gastonvallasciani/4to20mA-Transmitter/README.md

# 4to20mA-Transmitter
4to20mA Transmitter, I2C and UART Bridges, Hardware Reset
