gastonvallasciani/4to20mA-Transmitter/Pinout.png

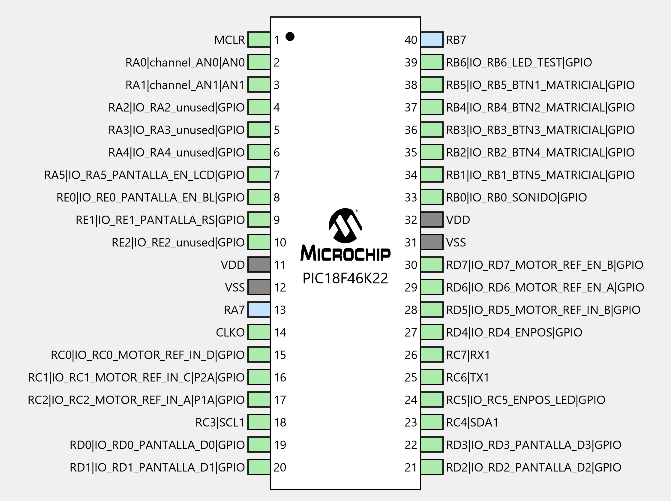
Pinout.png
