gastonvallasciani/4to20mA-Transmitter/(list of files, cad)

Other CAD files:
4to20mA-Transmitter.X/dist/default/production/Brainiac.production.obj
