gastonvallasciani/4to20mA-Transmitter/4to20mA-Transmitter.X/epwm3.h

/**
  ECCP3 Generated Driver File

  @Company
    Microchip Technology Inc.

  @File Name
    eccp3.c

  @Summary
    This is the generated driver implementation file for the ECCP3 driver using MPLAB(c) Code Configurator

  @Description
    This source file provides APIs for ECCP3.
    Generation Information :
        Product Revision  :  MPLAB(c) Code Configurator - 4.15
        Device            :  PIC18F46K22
        Driver Version    :  2.00
    The generated drivers are tested against the following:
        Compiler          :  XC8 1.35
        MPLAB             :  MPLAB X 3.40
*/

/*
    (c) 2016 Microchip Technology Inc. and its subsidiaries. You may use this
    software and any derivatives exclusively with Microchip products.

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
    IN NO EVENT WILL MICROCHIP BE LIABLE FOR ANY INDIRECT, SPECIAL, PUNITIVE,
    INCIDENTAL OR CONSEQUENTIAL LOSS, DAMAGE, COST OR EXPENSE OF ANY KIND
    WHATSOEVER RELATED TO THE SOFTWARE, HOWEVER CAUSED, EVEN IF MICROCHIP HAS
    BEEN ADVISED OF THE POSSIBILITY OR THE DAMAGES ARE FORESEEABLE. TO THE
    FULLEST EXTENT ALLOWED BY LAW, MICROCHIP'S TOTAL LIABILITY ON ALL CLAIMS IN
    ANY WAY RELATED TO THIS SOFTWARE WILL NOT EXCEED THE AMOUNT OF FEES, IF ANY,
    THAT YOU HAVE PAID DIRECTLY TO MICROCHIP FOR THIS SOFTWARE.

    MICROCHIP PROVIDES THIS SOFTWARE CONDITIONALLY UPON YOUR ACCEPTANCE OF THESE
    TERMS.
*/

#ifndef _EPWM3_H
#define _EPWM3_H

/**
  Section: Included Files
*/

#include <xc.h>
#include <stdint.h>

#ifdef __cplusplus  // Provide C++ Compatibility

    extern "C" {

#endif

/**
  Section: EPWM Module APIs
*/

  /**
  @Summary
    Initializes the EPWM3

  @Description
    This routine initializes the EPWM3_Initialize.
    This routine must be called before any other ECCP3 routine is called.
    This routine should only be called once during system initialization.

  @Preconditions
    None

  @Param
    None

  @Returns
    None

  @Comment
    

 @Example
    <code>
    uint16_t dutycycle;

    EPWM3_Initialize();
    EPWM3_LoadDutyValue(dutycycle);
    </code>
 */
void EPWM3_Initialize(void);

/**
  @Summary
    Loads 16-bit duty cycle.

  @Description
    This routine loads the 16 bit duty cycle value.

  @Preconditions
    EPWM3_Initialize() function should have been called before calling this function.

  @Param
    Pass in 16bit duty cycle value.

  @Returns
    None

  @Example
    <code>
    uint16_t dutycycle;

    EPWM3_Initialize();
    EPWM3_LoadDutyValue(dutycycle);
    </code>
*/
void EPWM3_LoadDutyValue(uint16_t dutyValue);

#ifdef __cplusplus  // Provide C++ Compatibility

    }

#endif

#endif  // _EPWM3_H
/**
 End of File
*/
