gastonvallasciani/4to20mA-Transmitter/(commit log)

2017-09-15 Hardware Reset
    [4a20ma.X.production.obj]
2017-09-18 Reordenando el repositorio
    [4a20ma.X.production.obj]
2018-01-29 Se actualizó el proyecto
    [4a20ma.X.production.obj, Brainiac.production.obj]
